davedapp/Thermocycler-of-a-Polymerase-Chain-Reaction-PCR-Chamber/README.md

# Thermocycler-of-a-Polymerase-chain-reaction-PCR-chamber-
